FilipeMaia/airknife/fork_shutter_assembly.stl

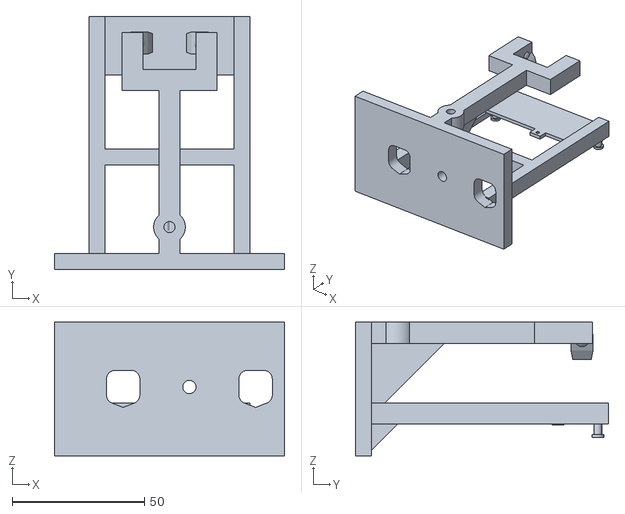
[picture p1: CAD file, 2026-11-10]
fork_shutter_assembly.stl
87.0 x 95.5 x 50.5
