FilipeMaia/airknife/shutter_assembly.stl

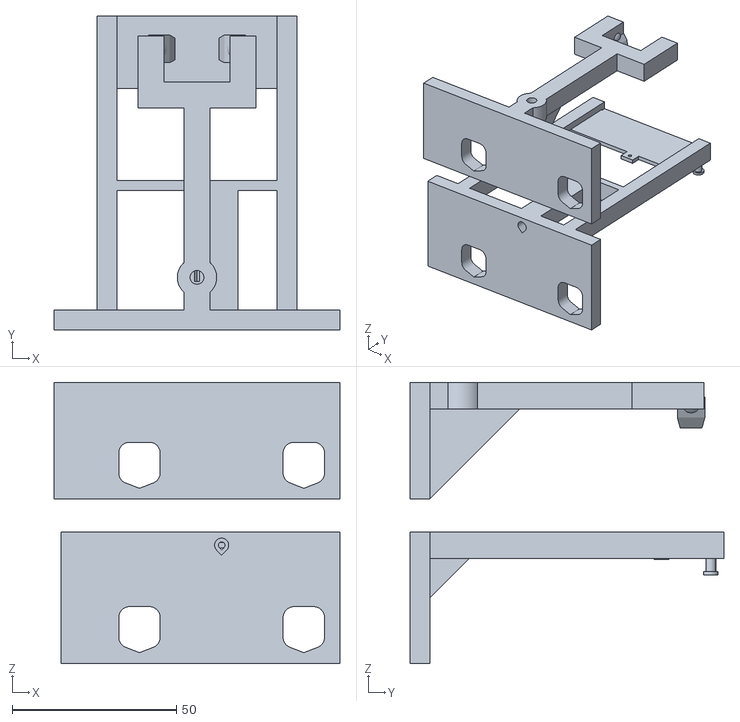
[picture p2: CAD file, 2026-11-10]
shutter_assembly.stl
87.0 x 95.5 x 85.5
