FilipeMaia/airknife/trap_assembly.stl

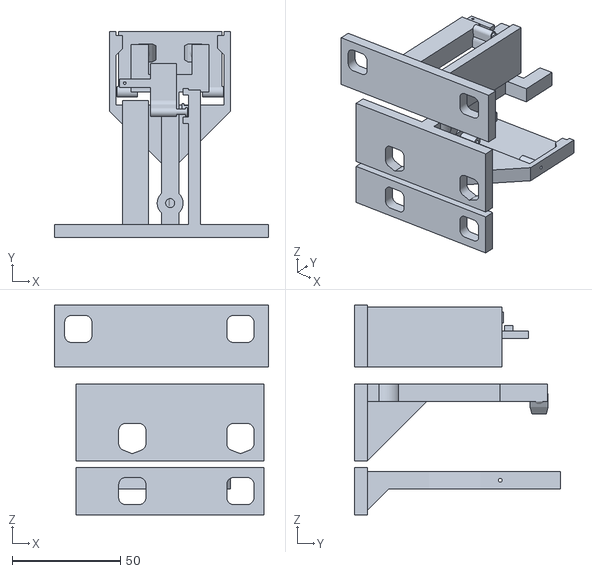
[picture p3: CAD file, 2026-11-10]
trap_assembly.stl
99.0 x 95.5 x 97.0
