FilipeMaia/airknife/shutter_frame.stl

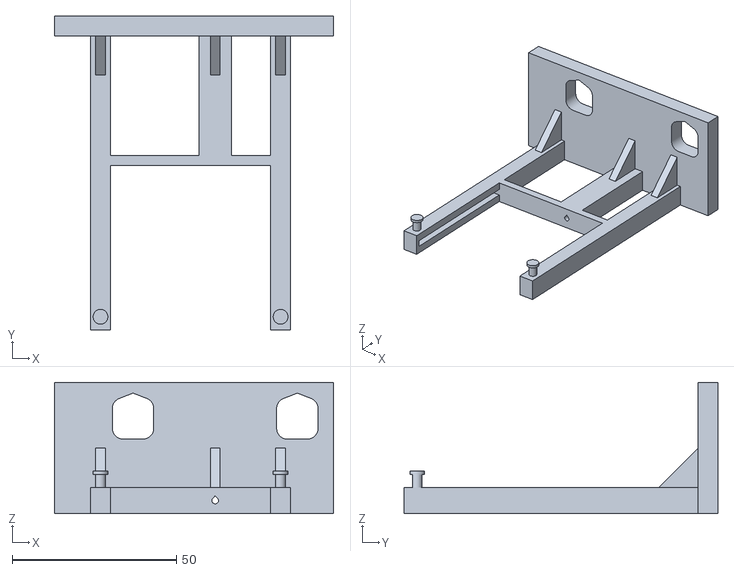
[picture p4: CAD file, 2026-11-10]
shutter_frame.stl
84.9 x 95.5 x 40.0
