FilipeMaia/airknife/airknife_horizontal.stl

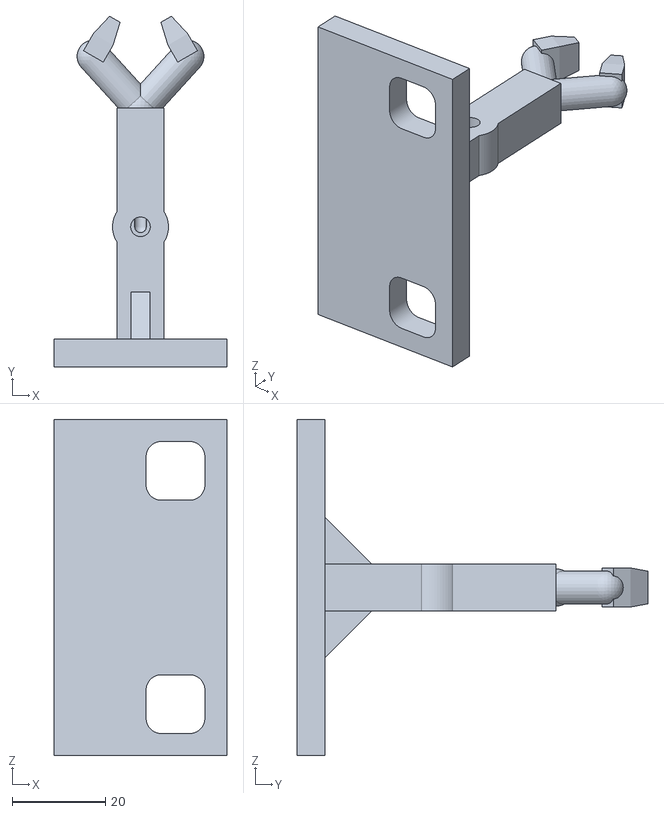
[picture p5: CAD file, 2026-11-10]
airknife_horizontal.stl
37.0 x 75.1 x 72.0
