FilipeMaia/airknife/trap_trigger.stl

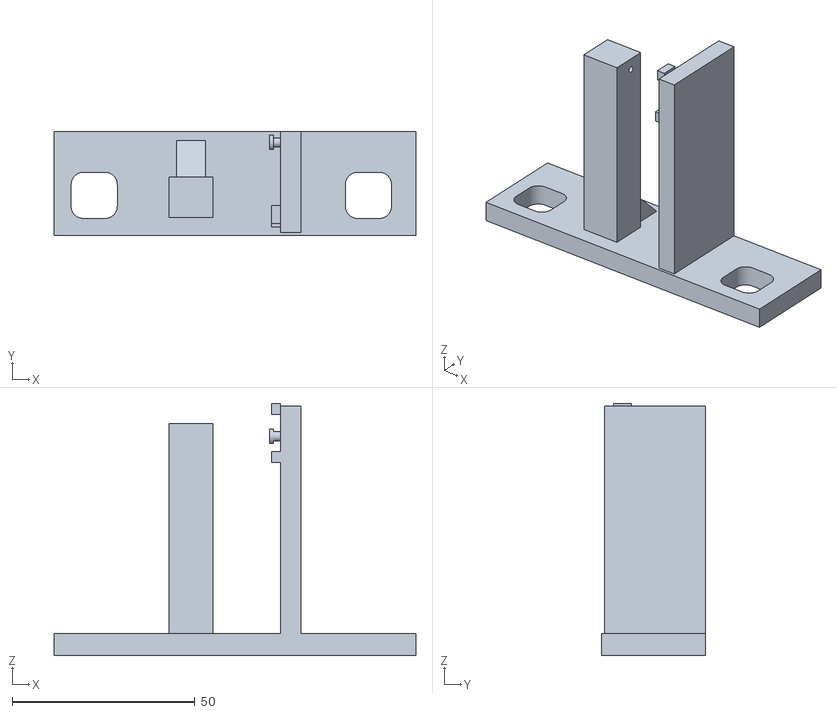
[picture p6: CAD file, 2026-11-10]
trap_trigger.stl
99.0 x 28.5 x 69.0
