FilipeMaia/airknife/fork_shutter.stl

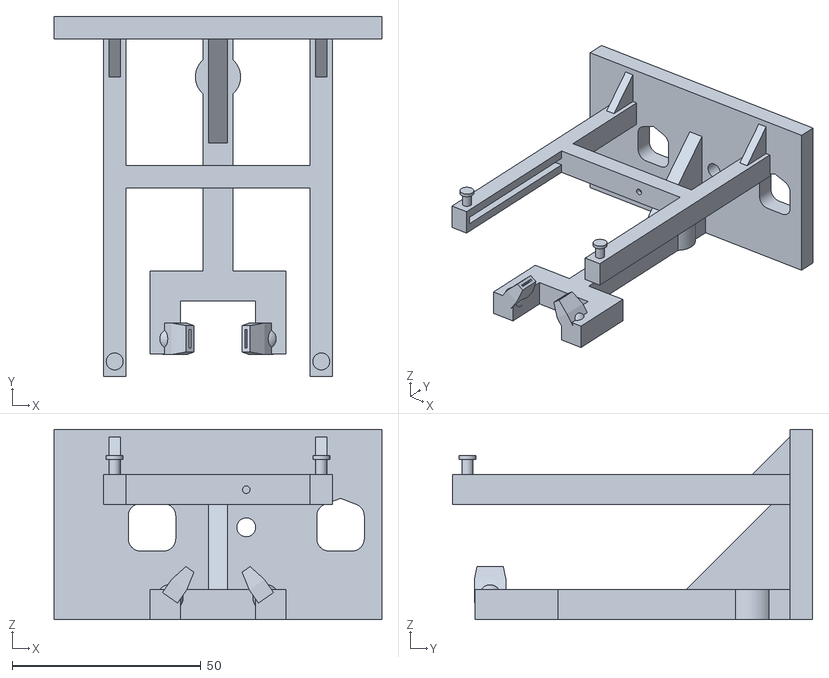
[picture p7: CAD file, 2026-11-10]
fork_shutter.stl
87.0 x 95.5 x 50.5
