FilipeMaia/airknife/trap_frame.stl

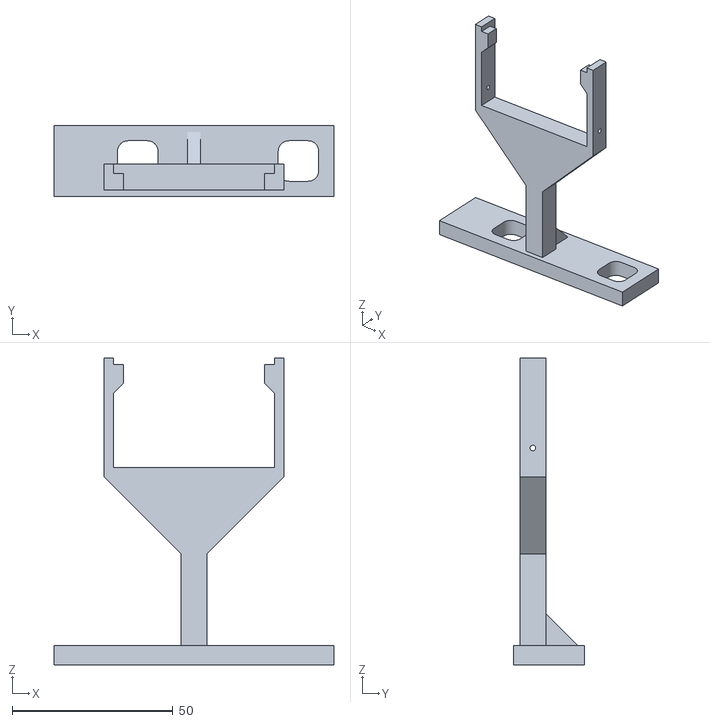
[picture p8: CAD file, 2026-11-10]
trap_frame.stl
87.0 x 22.0 x 95.5
