FilipeMaia/airknife/trap_door.stl

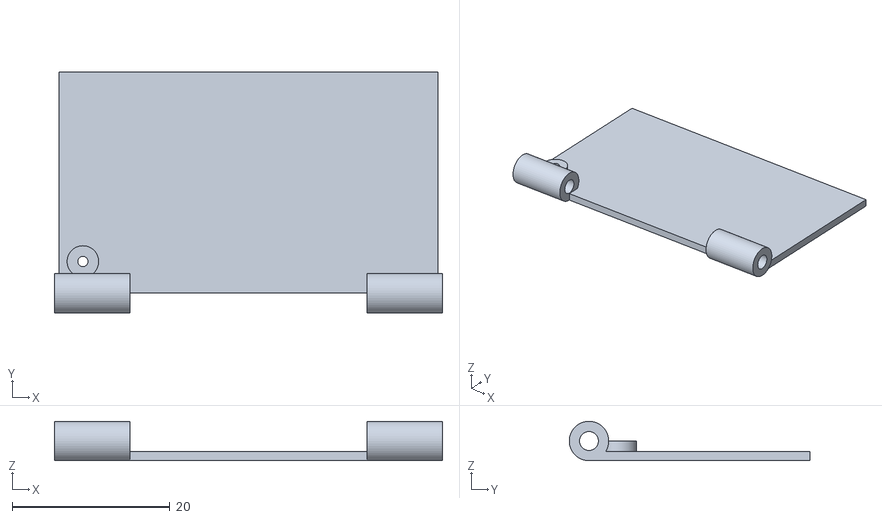
[picture p9: CAD file, 2026-11-10]
trap_door.stl
49.2 x 30.5 x 5.00
