FilipeMaia/airknife/airknife_breadboard.stl

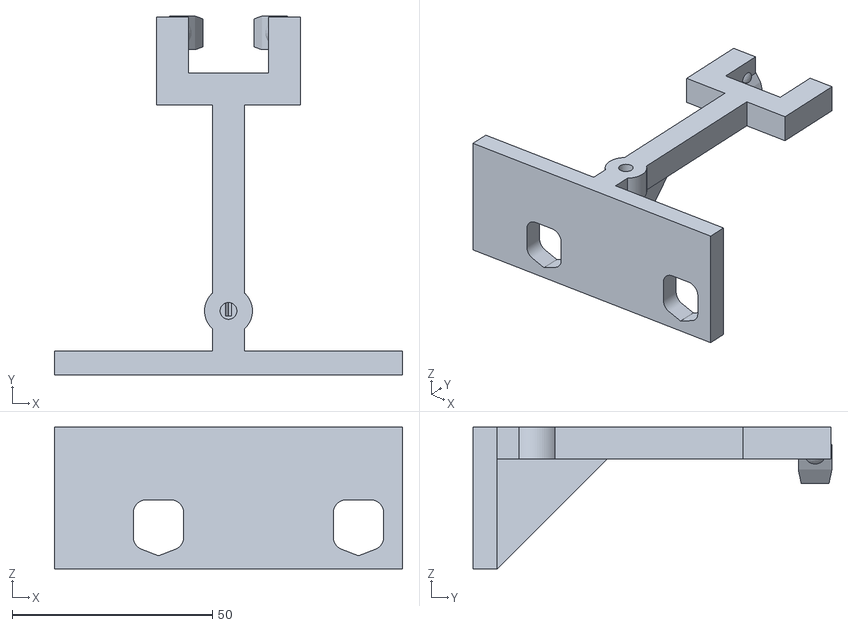
[picture p10: CAD file, 2026-11-10]
airknife_breadboard.stl
87.0 x 89.7 x 35.5
