FilipeMaia/airknife/airknife_pla.stl

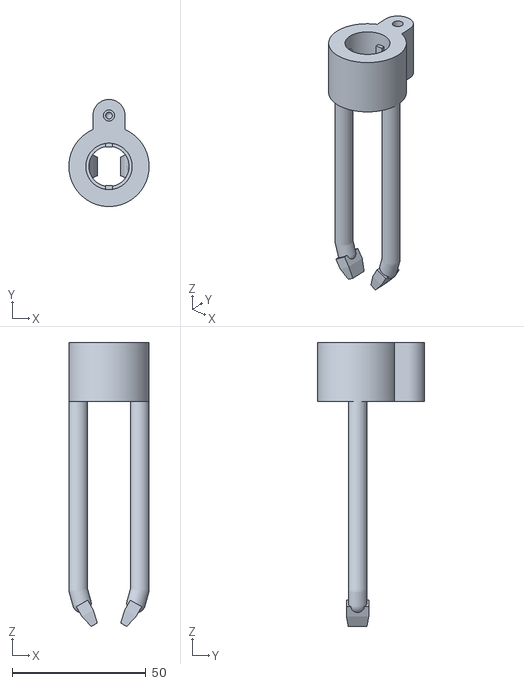
[picture p11: CAD file, 2026-11-10]
airknife_pla.stl
30.0 x 40.0 x 106.1
