FilipeMaia/airknife/airknife_manifold.stl

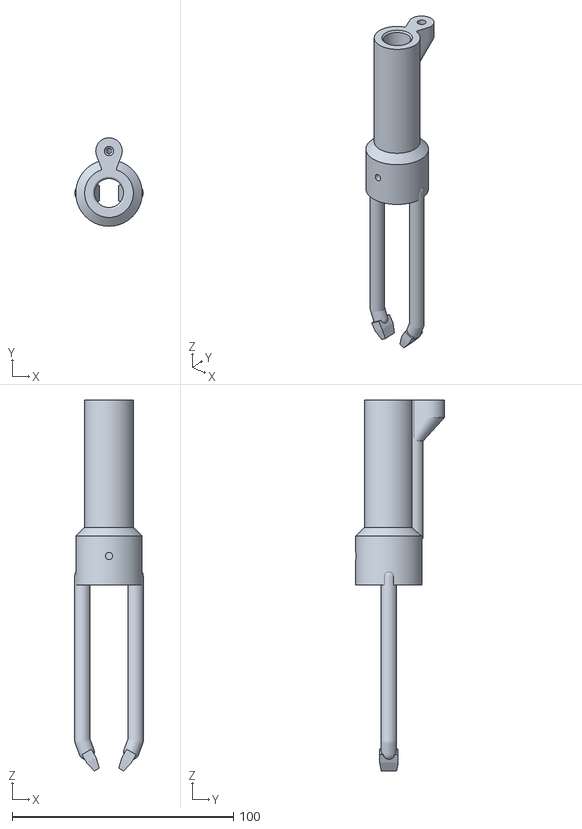
[picture p12: CAD file, 2026-11-10]
airknife_manifold.stl
31.0 x 40.0 x 167.6
