FilipeMaia/airknife/trap_lever.stl

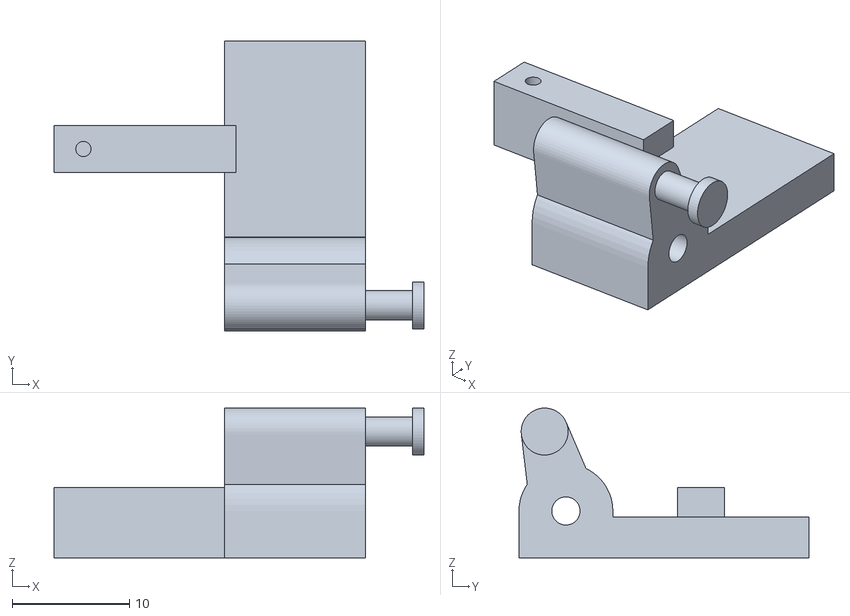
[picture p13: CAD file, 2026-11-10]
trap_lever.stl
31.5 x 24.7 x 12.8
