FilipeMaia/airknife/shutter.stl

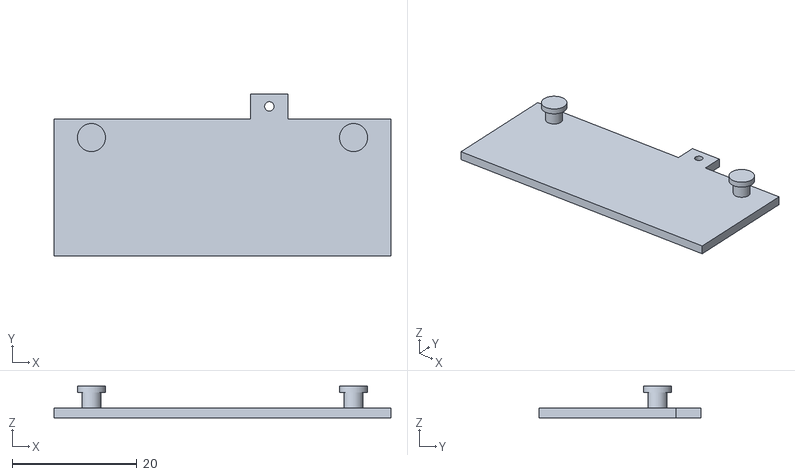
[picture p14: CAD file, 2026-11-10]
shutter.stl
54.0 x 26.0 x 5.10
