FilipeMaia/airknife/airknife_diagonal.stl

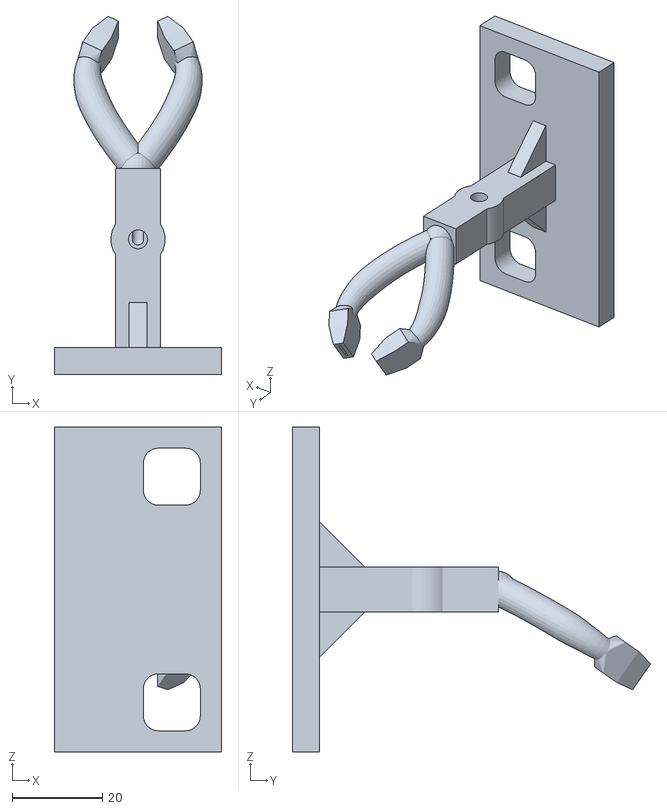
[picture p15: CAD file, 2026-11-10]
airknife_diagonal.stl
37.0 x 79.4 x 72.0
